prakharmaurya/prasad-dispenser/cad/previews/plate_1.png

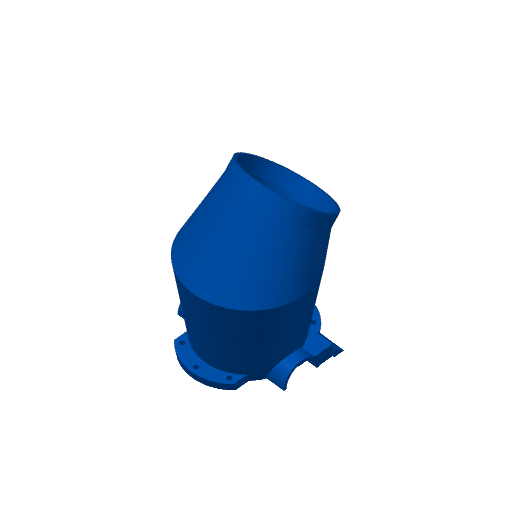
cad/previews/plate_1.png
