prakharmaurya/prasad-dispenser/cad/previews/plate_3.png

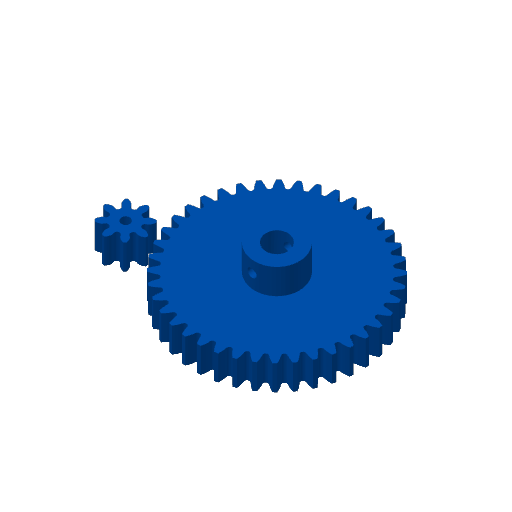
cad/previews/plate_3.png
