prakharmaurya/prasad-dispenser/cad/previews/plate_4.png

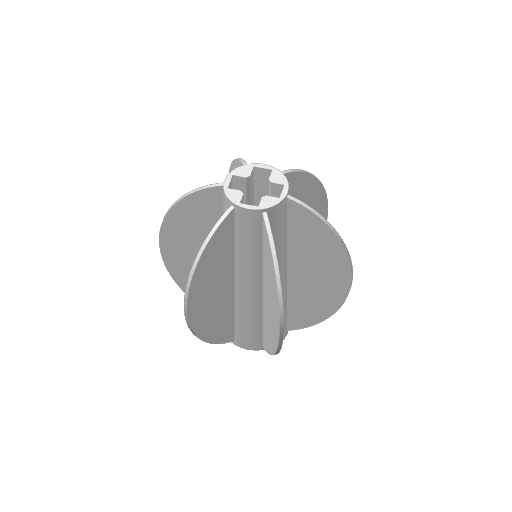
cad/previews/plate_4.png
