prakharmaurya/prasad-dispenser/cad/previews/plate_5.png

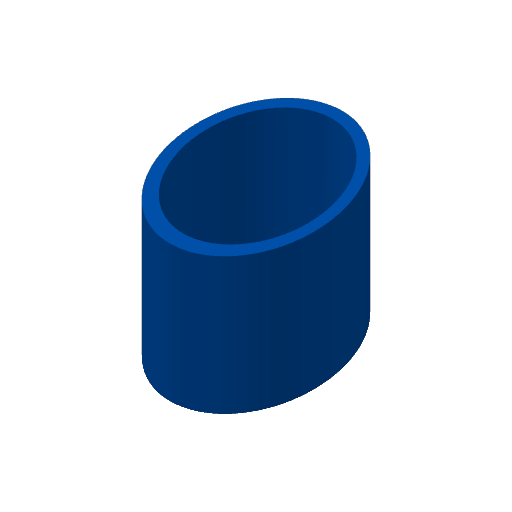
cad/previews/plate_5.png
