prakharmaurya/prasad-dispenser/cad/previews/plate_6.png

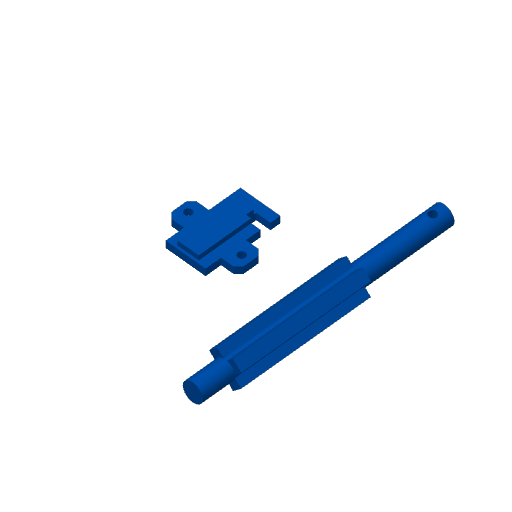
cad/previews/plate_6.png
