prakharmaurya/prasad-dispenser/cad/previews/plate_7.png

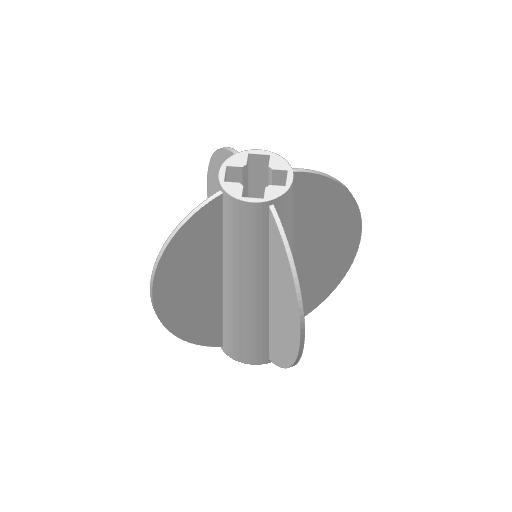
cad/previews/plate_7.png
