prakharmaurya/prasad-dispenser/cad/main rotor.stl

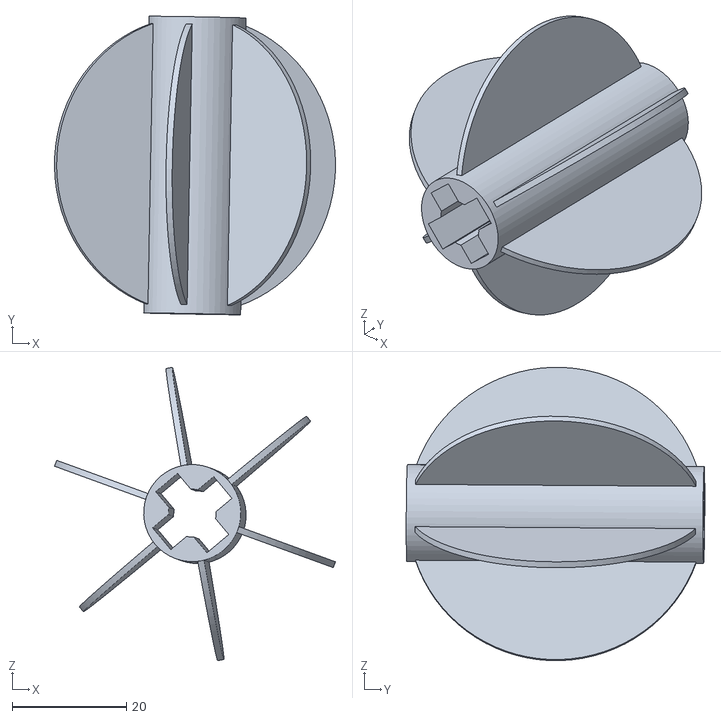
[picture p7: CAD file, 2026-10-24]
cad/main rotor.stl
49.2 x 52.3 x 51.4
