prakharmaurya/prasad-dispenser/cad/main_axis.stl

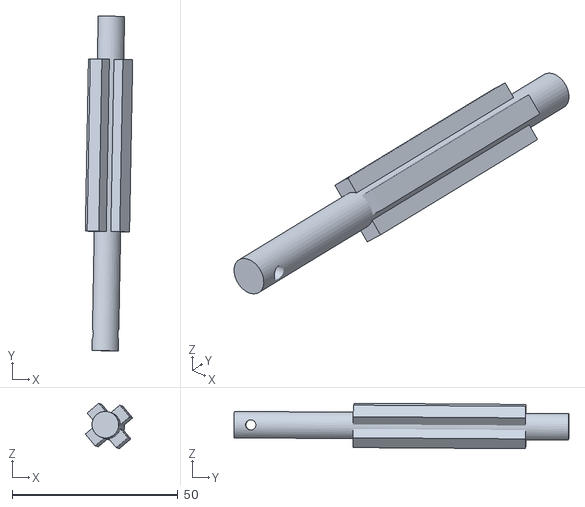
[picture p8: CAD file, 2026-10-24]
cad/main_axis.stl
14.3 x 101.1 x 13.7
