prakharmaurya/prasad-dispenser/cad/main gear.stl

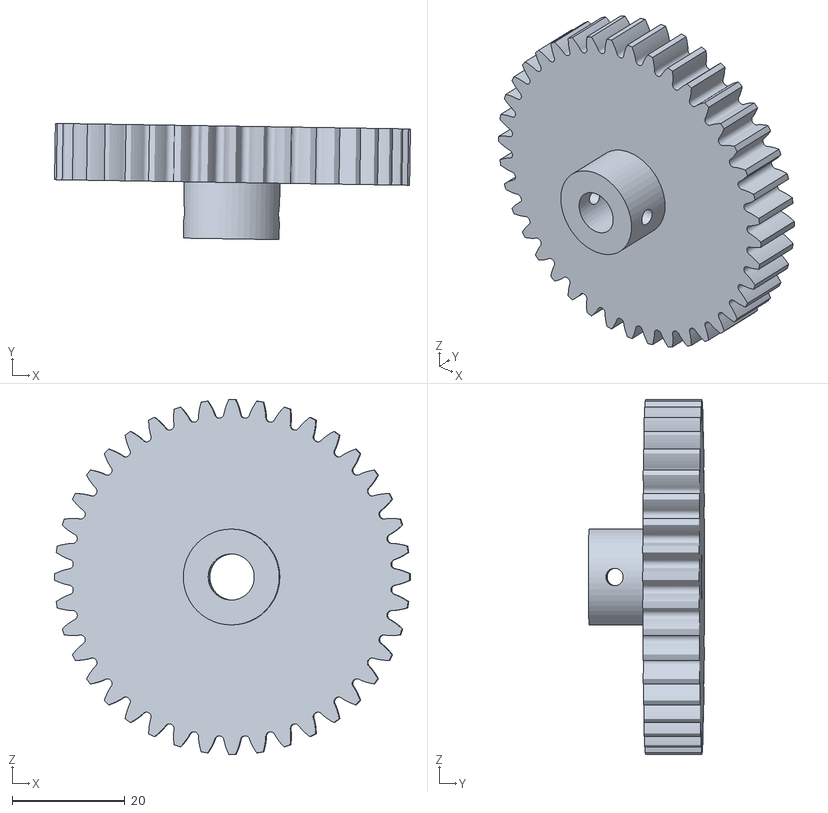
[picture p9: CAD file, 2026-10-24]
cad/main gear.stl
63.1 x 20.6 x 63.0
