prakharmaurya/prasad-dispenser/cad/nozzle.stl

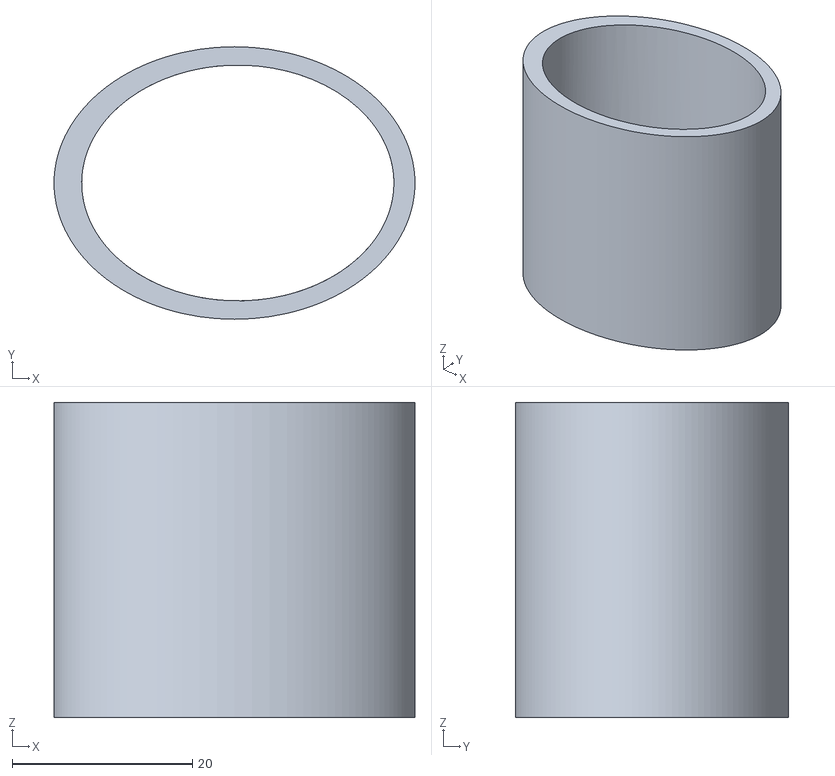
[picture p10: CAD file, 2026-10-24]
cad/nozzle.stl
40.1 x 30.3 x 35.0
