prakharmaurya/prasad-dispenser/cad/body top.stl

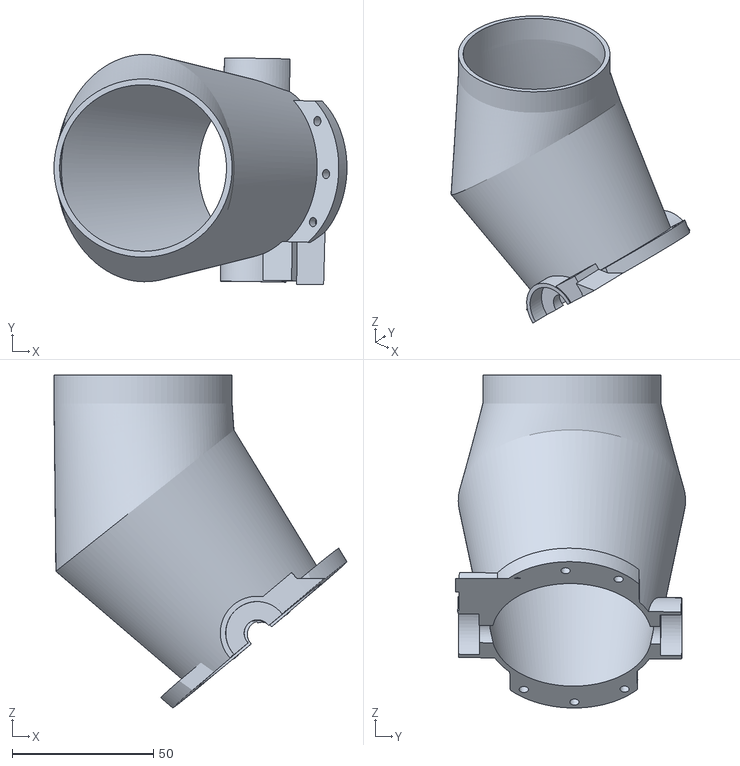
[picture p11: CAD file, 2026-10-24]
cad/body top.stl
103.6 x 81.4 x 117.8
