prakharmaurya/prasad-dispenser/cad/4_blade.stl

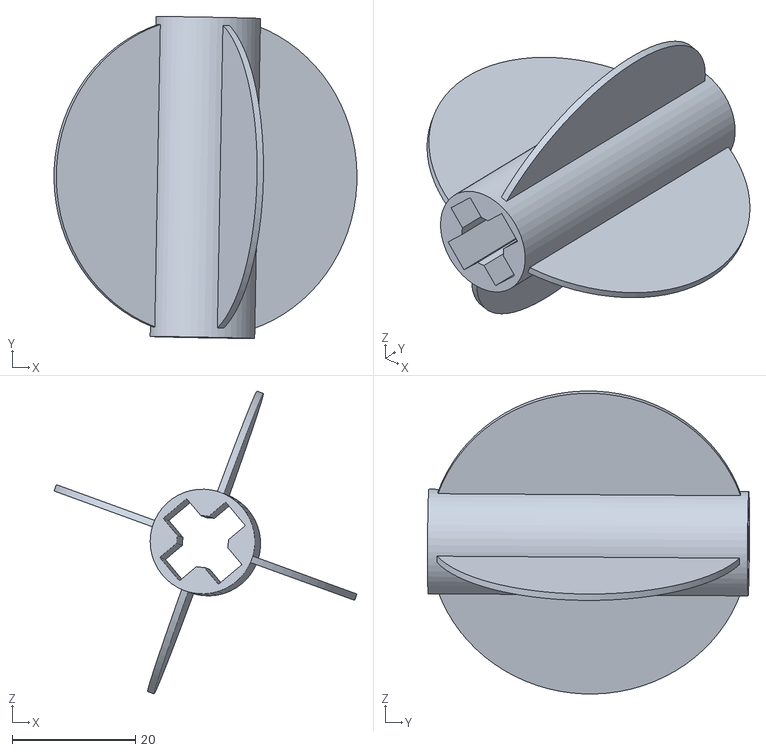
[picture p12: CAD file, 2026-10-24]
cad/4_blade.stl
49.2 x 52.3 x 49.2
