prakharmaurya/prasad-dispenser/cad/motor_gear.stl

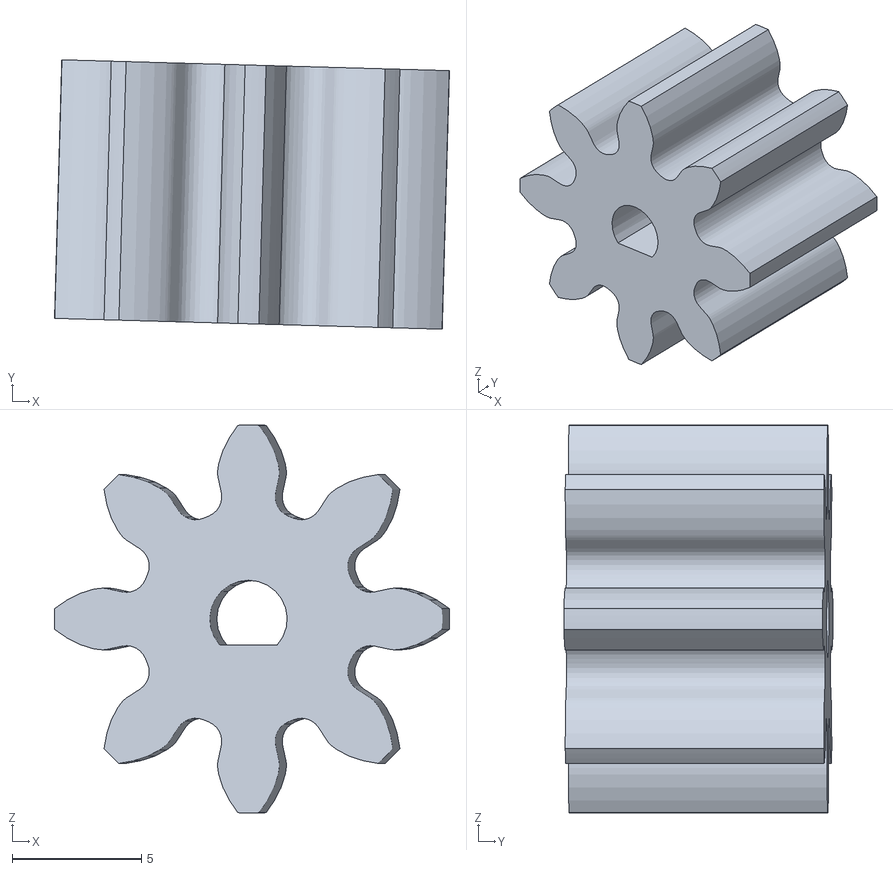
[picture p13: CAD file, 2026-10-24]
cad/motor_gear.stl
15.3 x 10.4 x 15.0
