prakharmaurya/prasad-dispenser/cad/body_bottom.stl

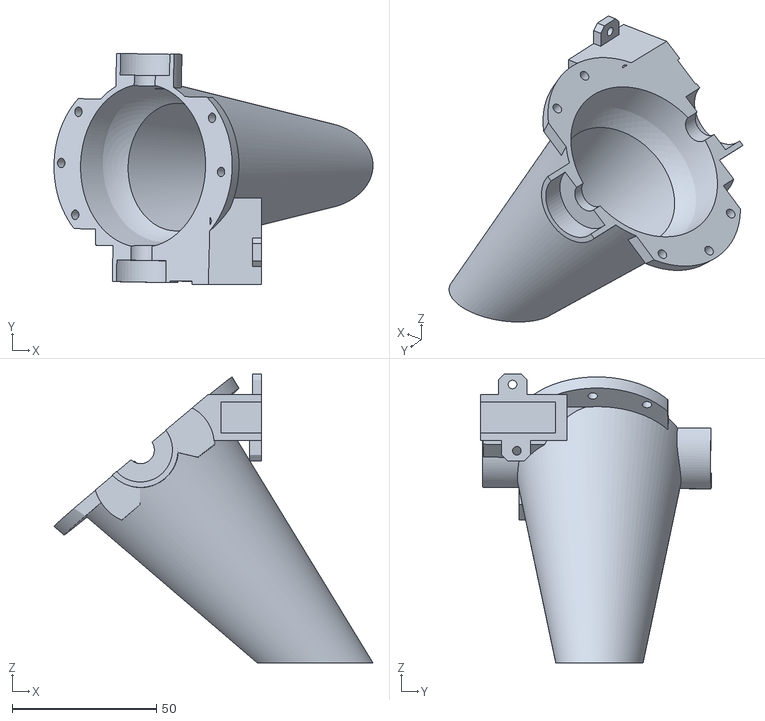
[picture p14: CAD file, 2026-10-24]
cad/body_bottom.stl
110.4 x 80.1 x 99.9
