prakharmaurya/prasad-dispenser/cad/motor_cover.stl

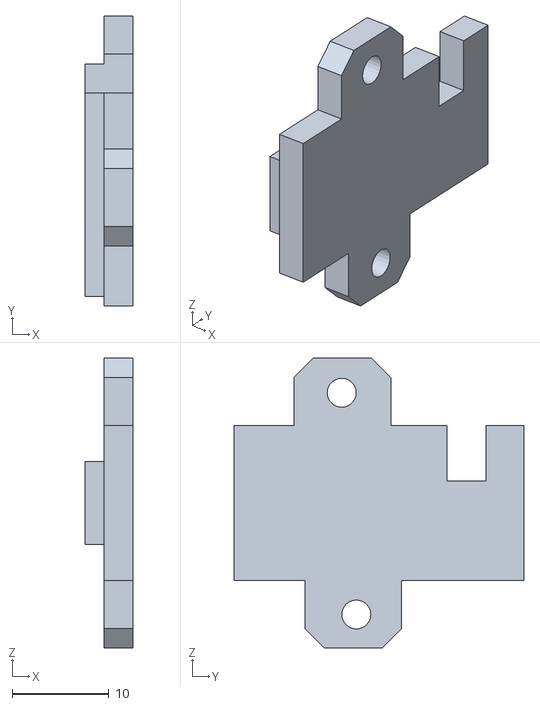
[picture p15: CAD file, 2026-10-24]
cad/motor_cover.stl
5.00 x 30.0 x 30.0
