prakharmaurya/prasad-dispenser/cad/prasad_v3.1.3mf

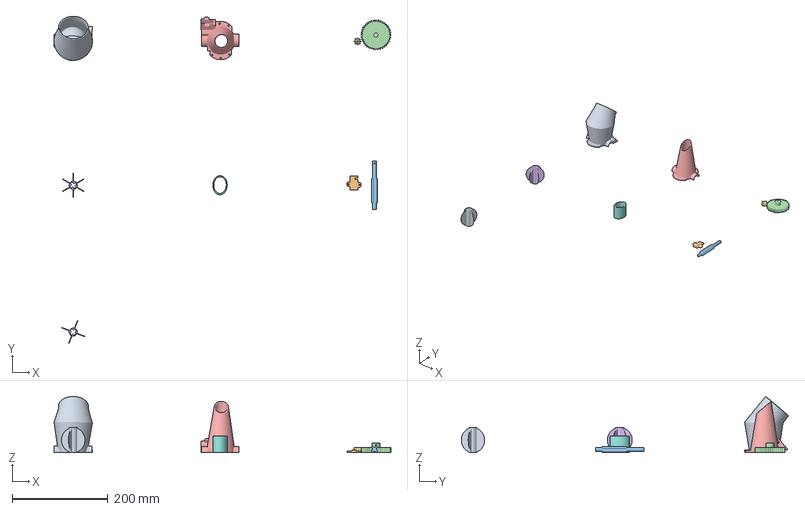
[picture p16: CAD file, 2026-10-24]
cad/prasad_v3.1.3mf
705.1 x 685.2 x 117.2 mm
body top.stl
motor_cover.stl
main_axis.stl
main gear.stl
body_bottom.stl
main rotor.stl
motor_gear.stl
nozzle.stl
4_blade.stl
